Totoleheros/tppa-compliant-motorized-polar-alignment/IMAGES/fysetc_e4_layout.jpg

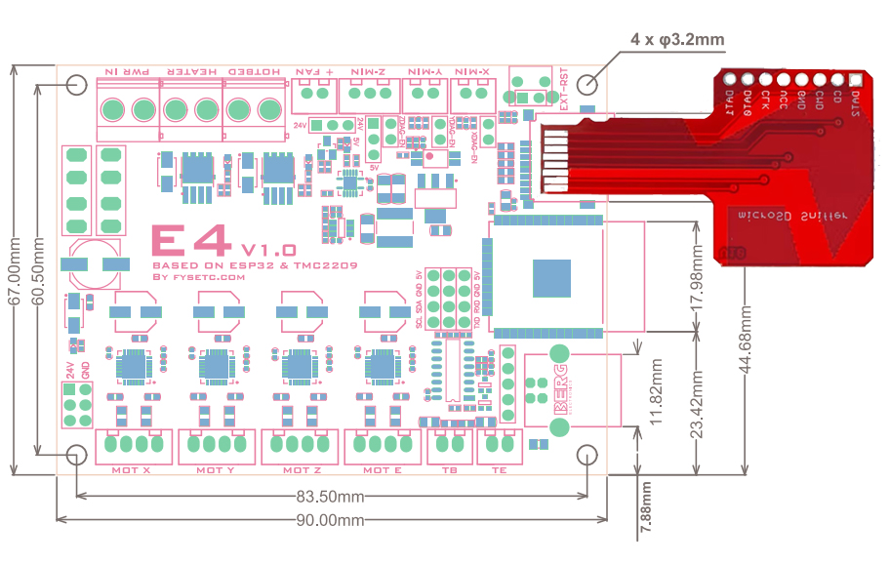
IMAGES/fysetc_e4_layout.jpg
