Totoleheros/tppa-compliant-motorized-polar-alignment/IMAGES/Parts_Proto/load-bearing.jpg

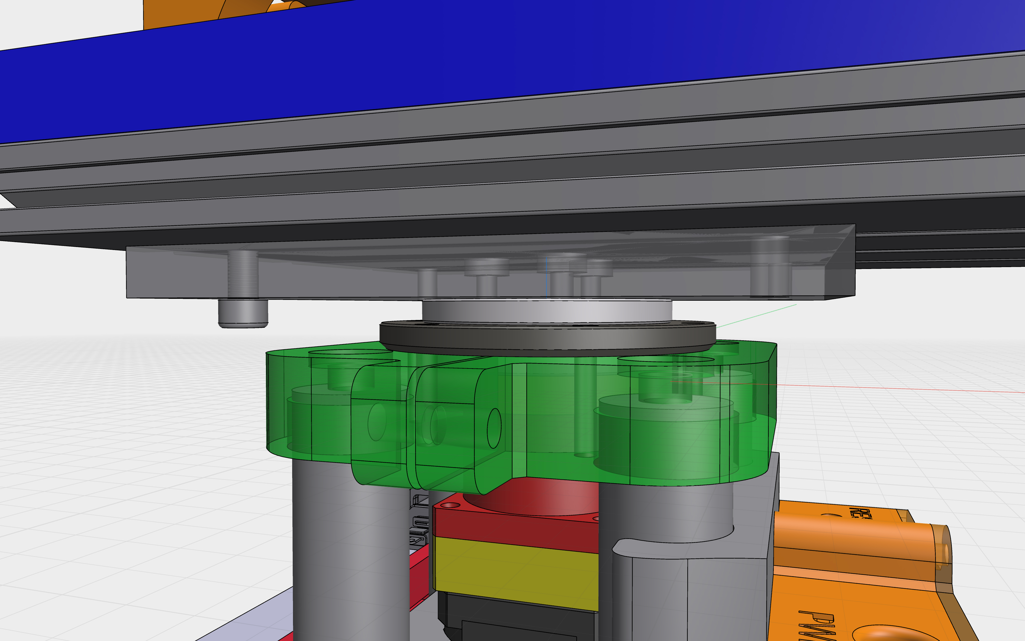
IMAGES/Parts_Proto/load-bearing.jpg
