Totoleheros/tppa-compliant-motorized-polar-alignment/IMAGES/ASSEMBLY_Proto/3D_Model/25.jpg

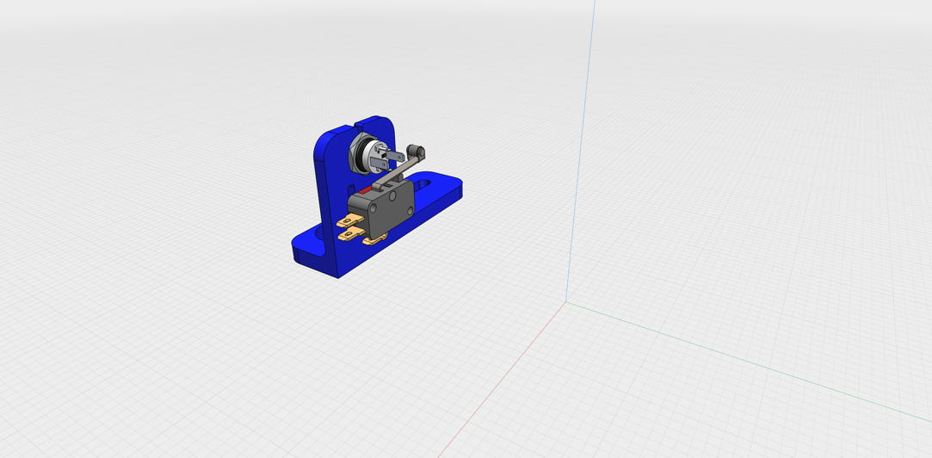
IMAGES/ASSEMBLY_Proto/3D_Model/25.jpg
