Totoleheros/tppa-compliant-motorized-polar-alignment/IMAGES/ASSEMBLY_Proto/3D_Model/31.jpg

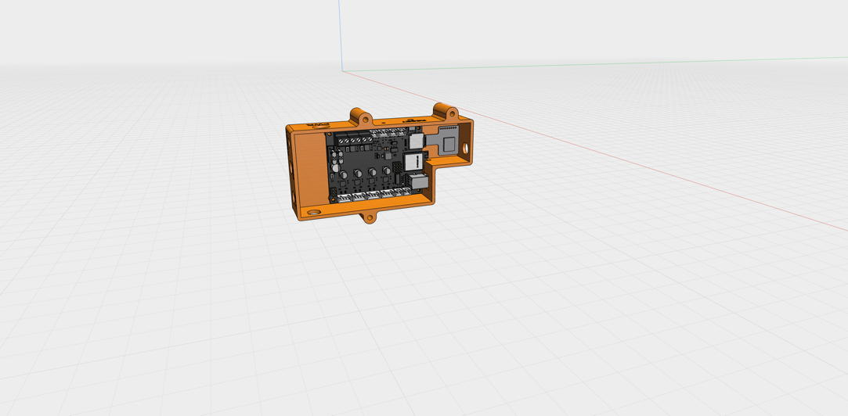
IMAGES/ASSEMBLY_Proto/3D_Model/31.jpg
