Totoleheros/tppa-compliant-motorized-polar-alignment/IMAGES/ASSEMBLY_Proto/Real_World/ALT-AZM junction/IMG_2272.jpg

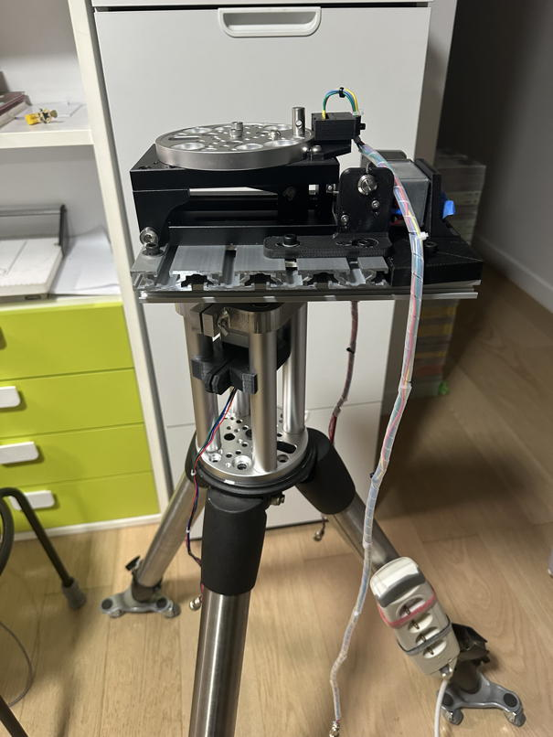
IMAGES/ASSEMBLY_Proto/Real_World/ALT-AZM junction/IMG_2272.jpg
