Totoleheros/tppa-compliant-motorized-polar-alignment/IMAGES/ASSEMBLY_Proto/Real_World/AZM/IMG_2148.jpg

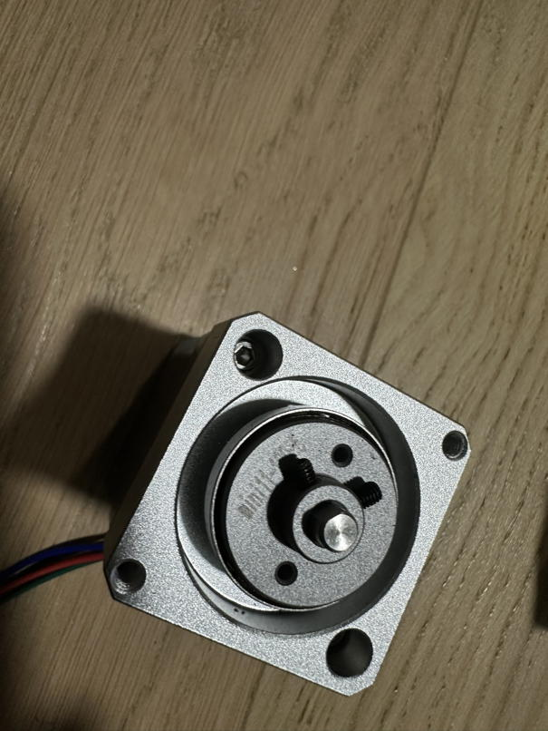
IMAGES/ASSEMBLY_Proto/Real_World/AZM/IMG_2148.jpg
