Totoleheros/tppa-compliant-motorized-polar-alignment/IMAGES/ASSEMBLY_Proto/Real_World/AZM/IMG_2177.jpg

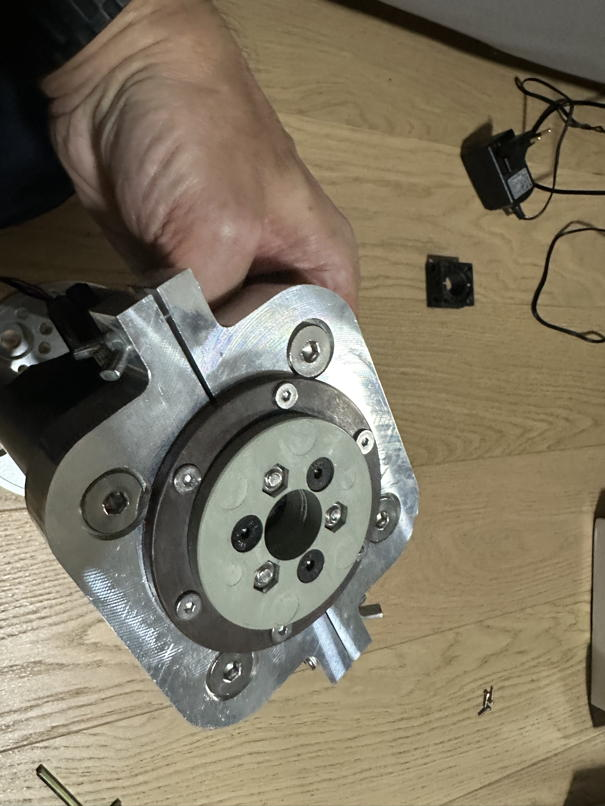
IMAGES/ASSEMBLY_Proto/Real_World/AZM/IMG_2177.jpg
