Totoleheros/tppa-compliant-motorized-polar-alignment/IMAGES/ASSEMBLY_Proto/Real_World/Final Assembly and Scope Loading/IMG_2288.jpg

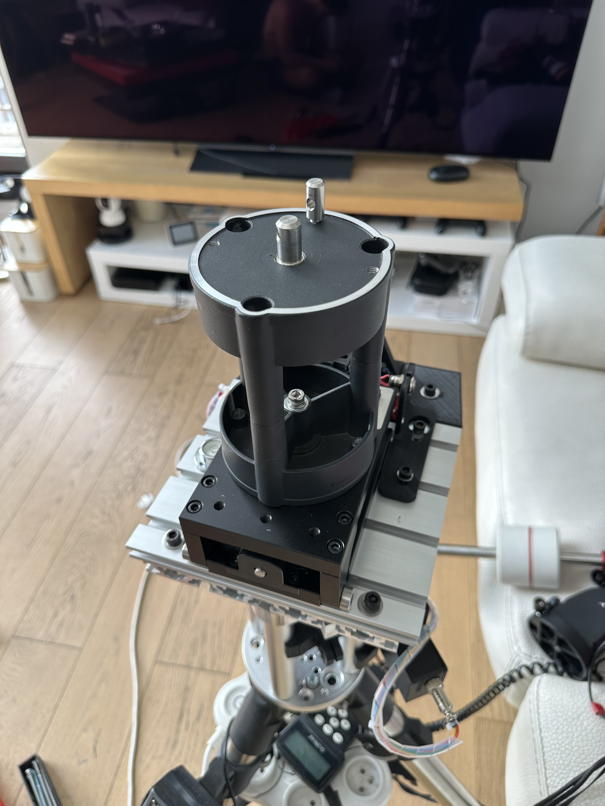
IMAGES/ASSEMBLY_Proto/Real_World/Final Assembly and Scope Loading/IMG_2288.jpg
