Totoleheros/tppa-compliant-motorized-polar-alignment/IMAGES/ASSEMBLY_Proto/Real_World/Fysetc/IMG_2209.jpg

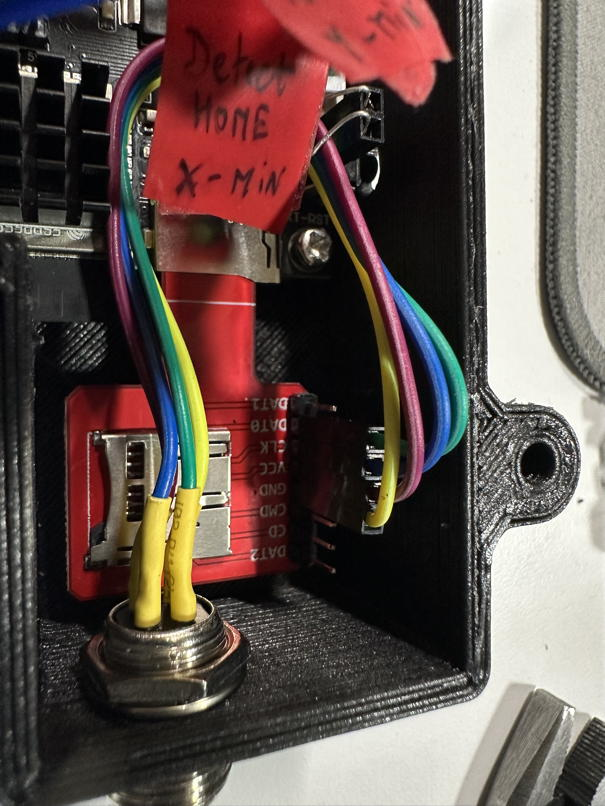
IMAGES/ASSEMBLY_Proto/Real_World/Fysetc/IMG_2209.jpg
