Totoleheros/tppa-compliant-motorized-polar-alignment/IMAGES/ASSEMBLY_Proto/Real_World/Fysetc/IMG_2222.jpg

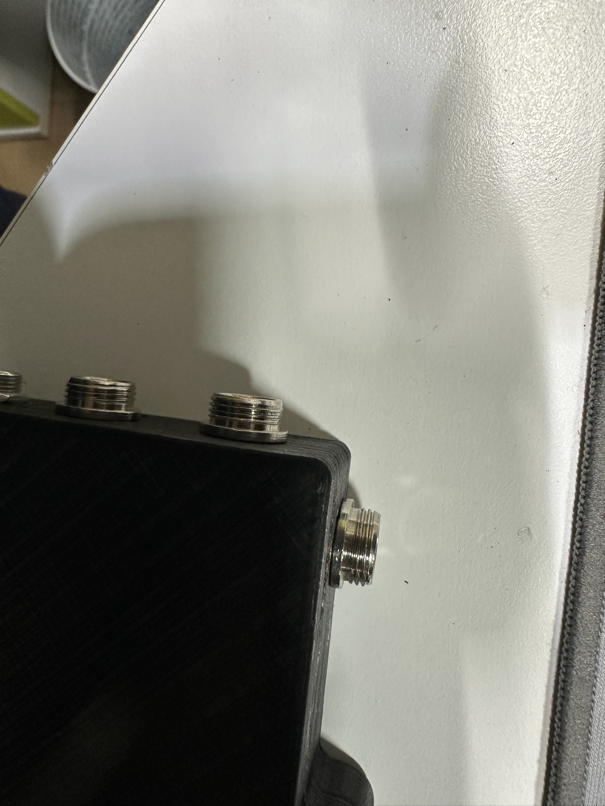
IMAGES/ASSEMBLY_Proto/Real_World/Fysetc/IMG_2222.jpg
