Totoleheros/tppa-compliant-motorized-polar-alignment/IMAGES/ASSEMBLY_Proto/Real_World/Ready to go/IMG_2300.jpg

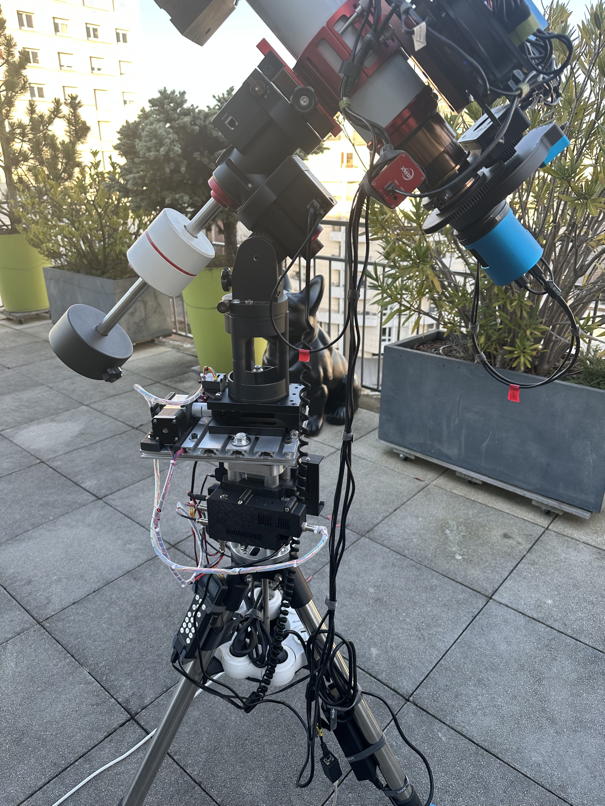
IMAGES/ASSEMBLY_Proto/Real_World/Ready to go/IMG_2300.jpg
