Totoleheros/tppa-compliant-motorized-polar-alignment/IMAGES/ASSEMBLY_V2/3D_Model/23.jpg

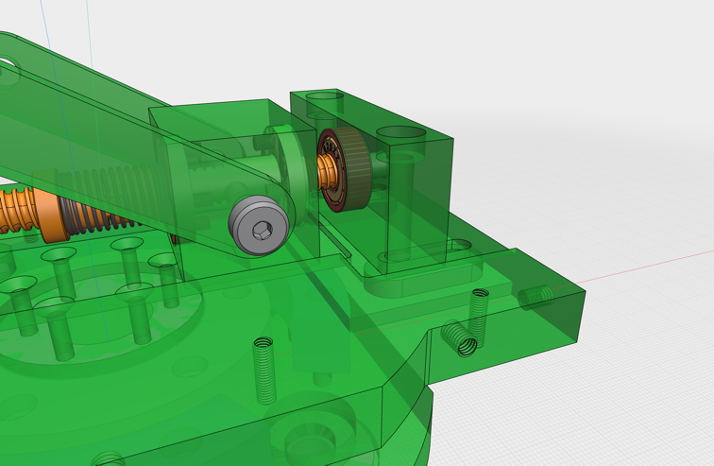
IMAGES/ASSEMBLY_V2/3D_Model/23.jpg
