Totoleheros/tppa-compliant-motorized-polar-alignment/IMAGES/ASSEMBLY_V2/3D_Model/25.jpg

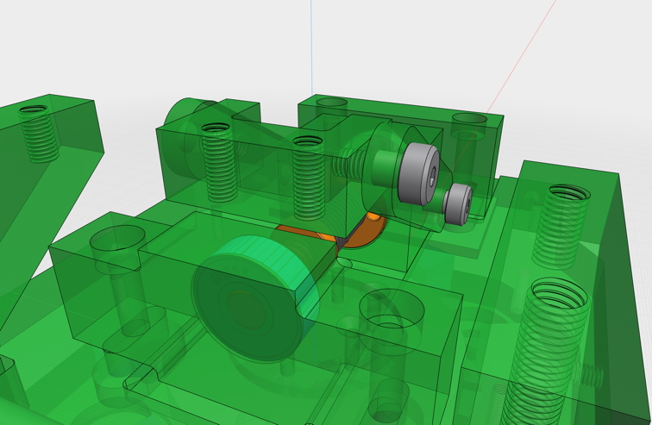
IMAGES/ASSEMBLY_V2/3D_Model/25.jpg
