Totoleheros/tppa-compliant-motorized-polar-alignment/IMAGES/ASSEMBLY_V2/Real_World/IMG_2485.jpg

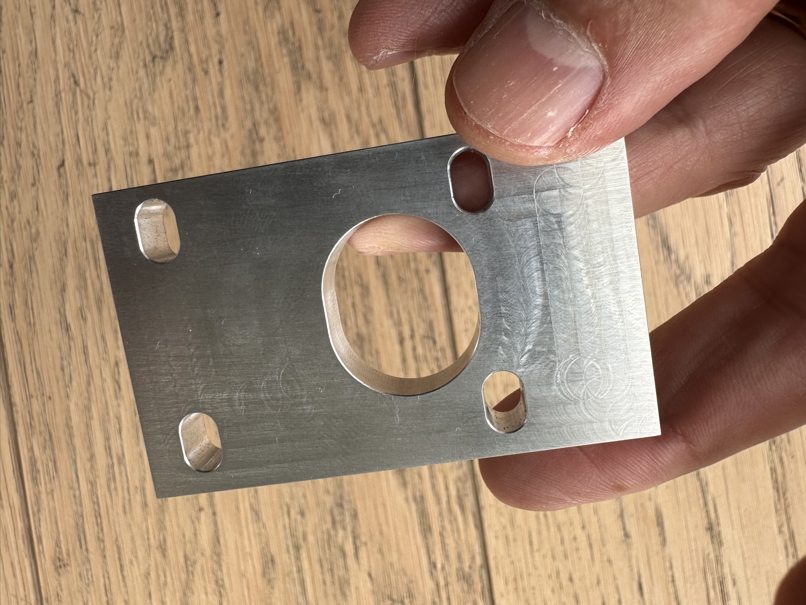
IMAGES/ASSEMBLY_V2/Real_World/IMG_2485.jpg
