Totoleheros/tppa-compliant-motorized-polar-alignment/IMAGES/ASSEMBLY_V2_Reinforced/Real_World/IMG_2876.jpg

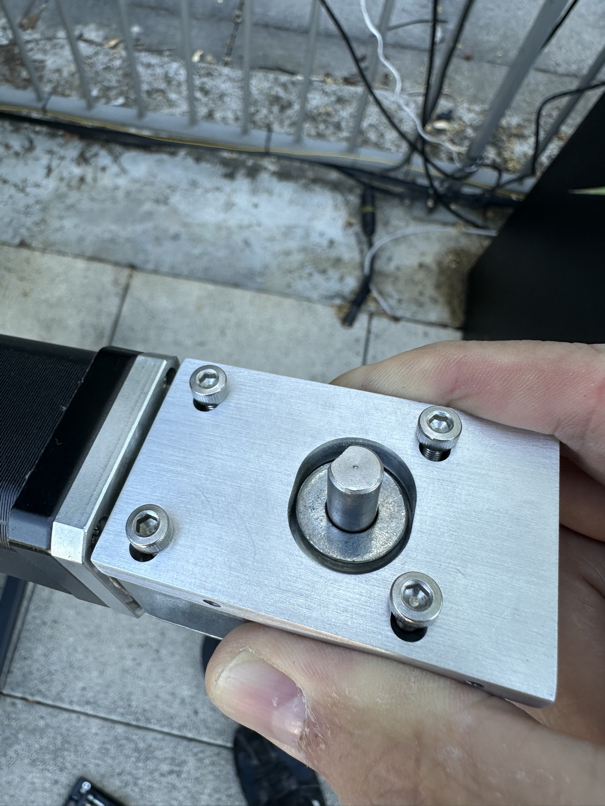
IMAGES/ASSEMBLY_V2_Reinforced/Real_World/IMG_2876.jpg
