Totoleheros/tppa-compliant-motorized-polar-alignment/3D STEP Models/Manufacturing_Drawings_V2_2_reinforced/BASE_ALT.pdf

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

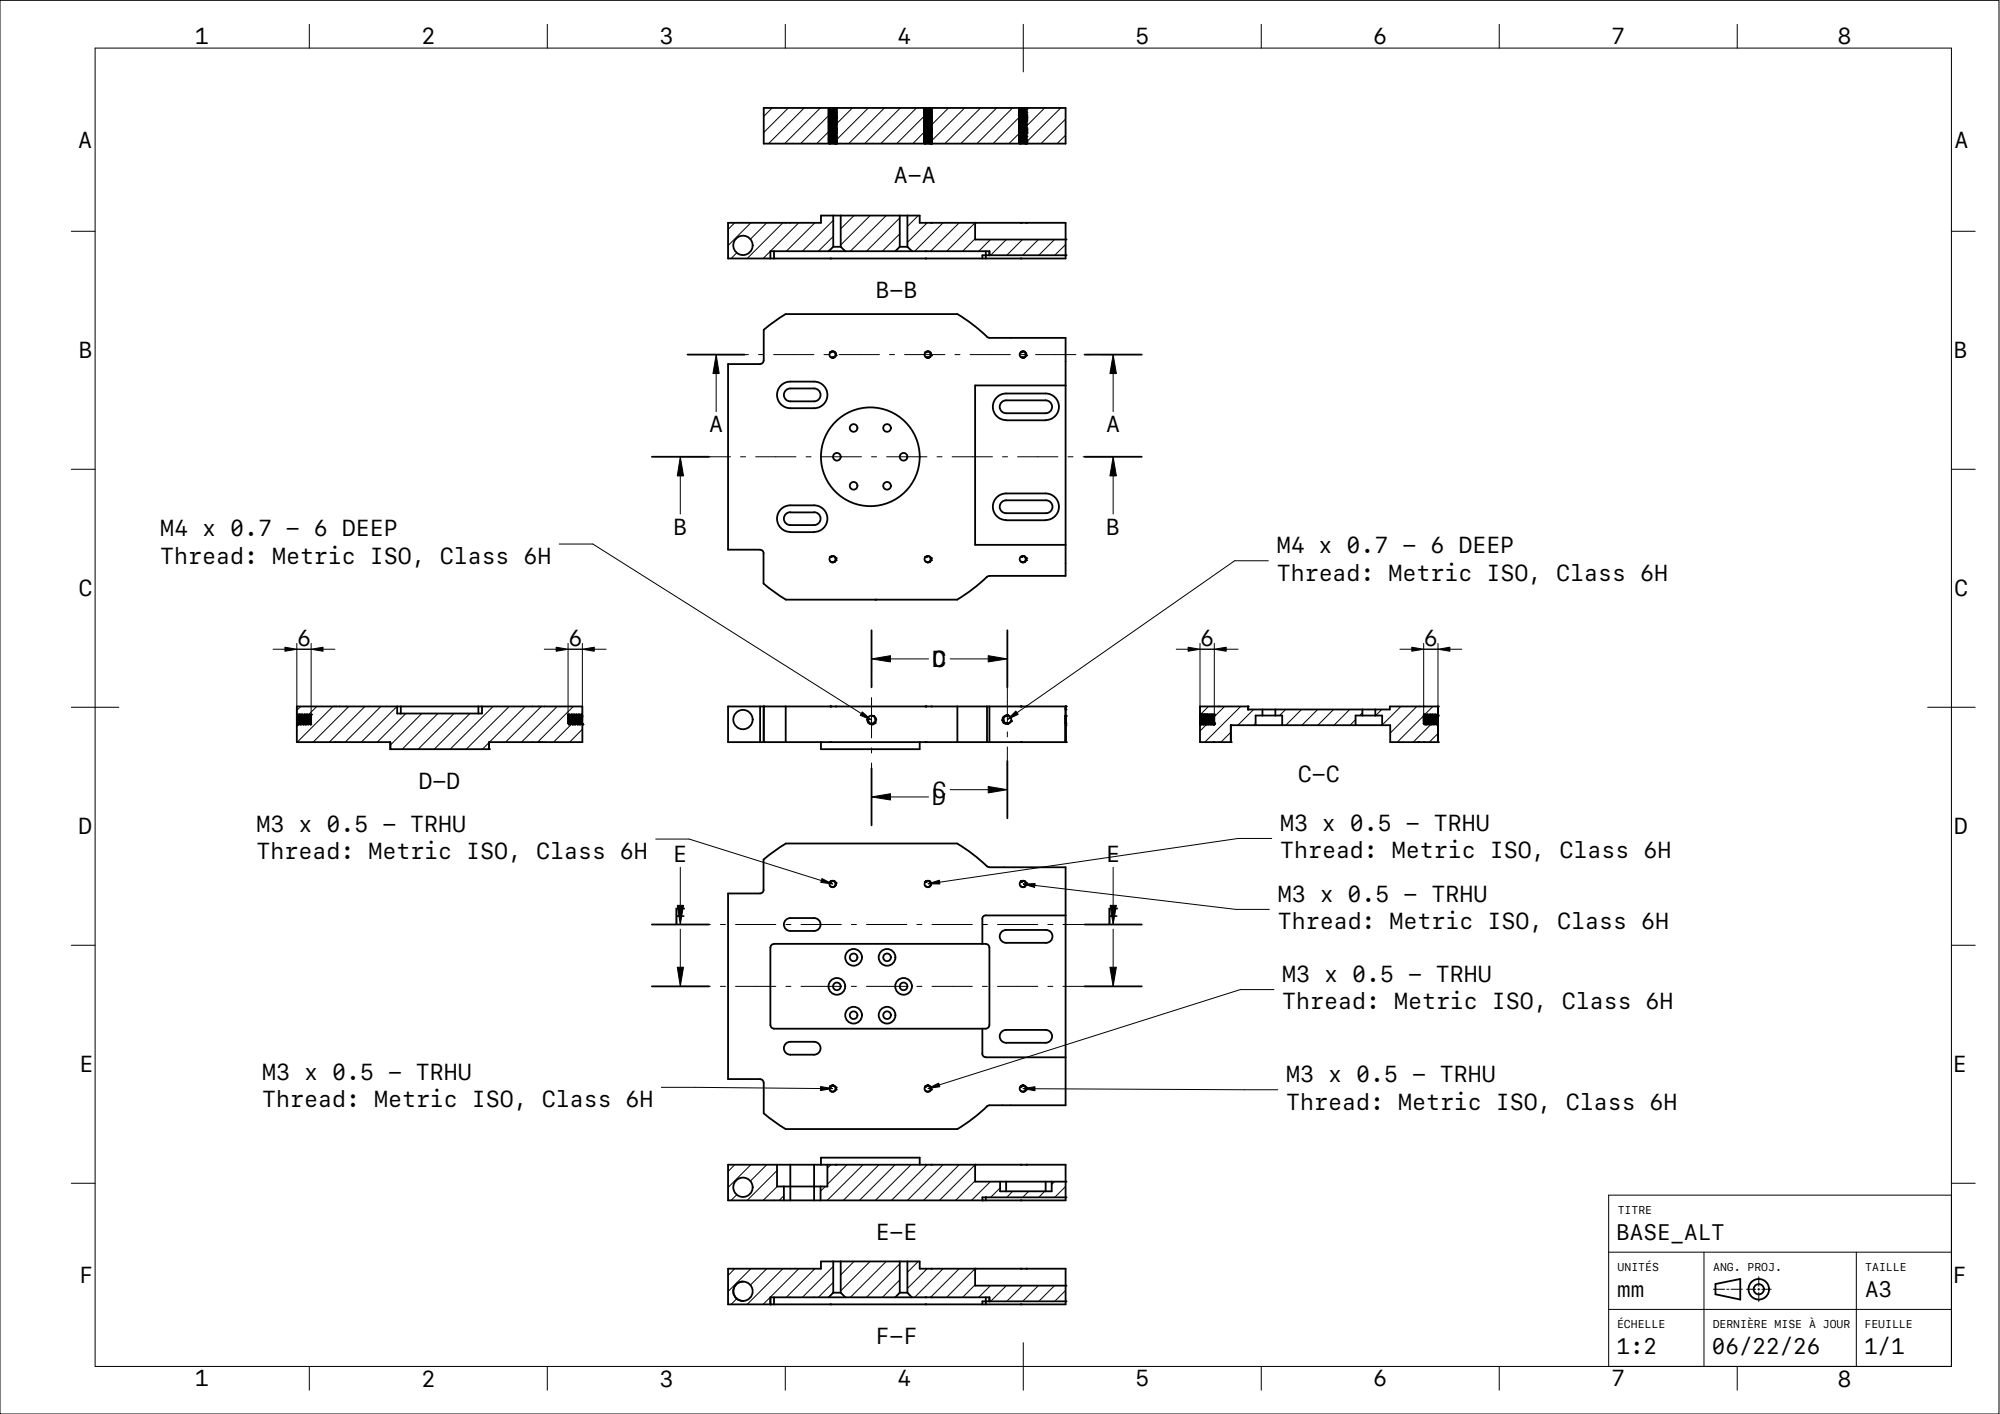
[picture p267: page 1]
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
