Totoleheros/tppa-compliant-motorized-polar-alignment/3D STEP Models/Manufacturing_Drawings_V2/Base_ALT_T.pdf

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

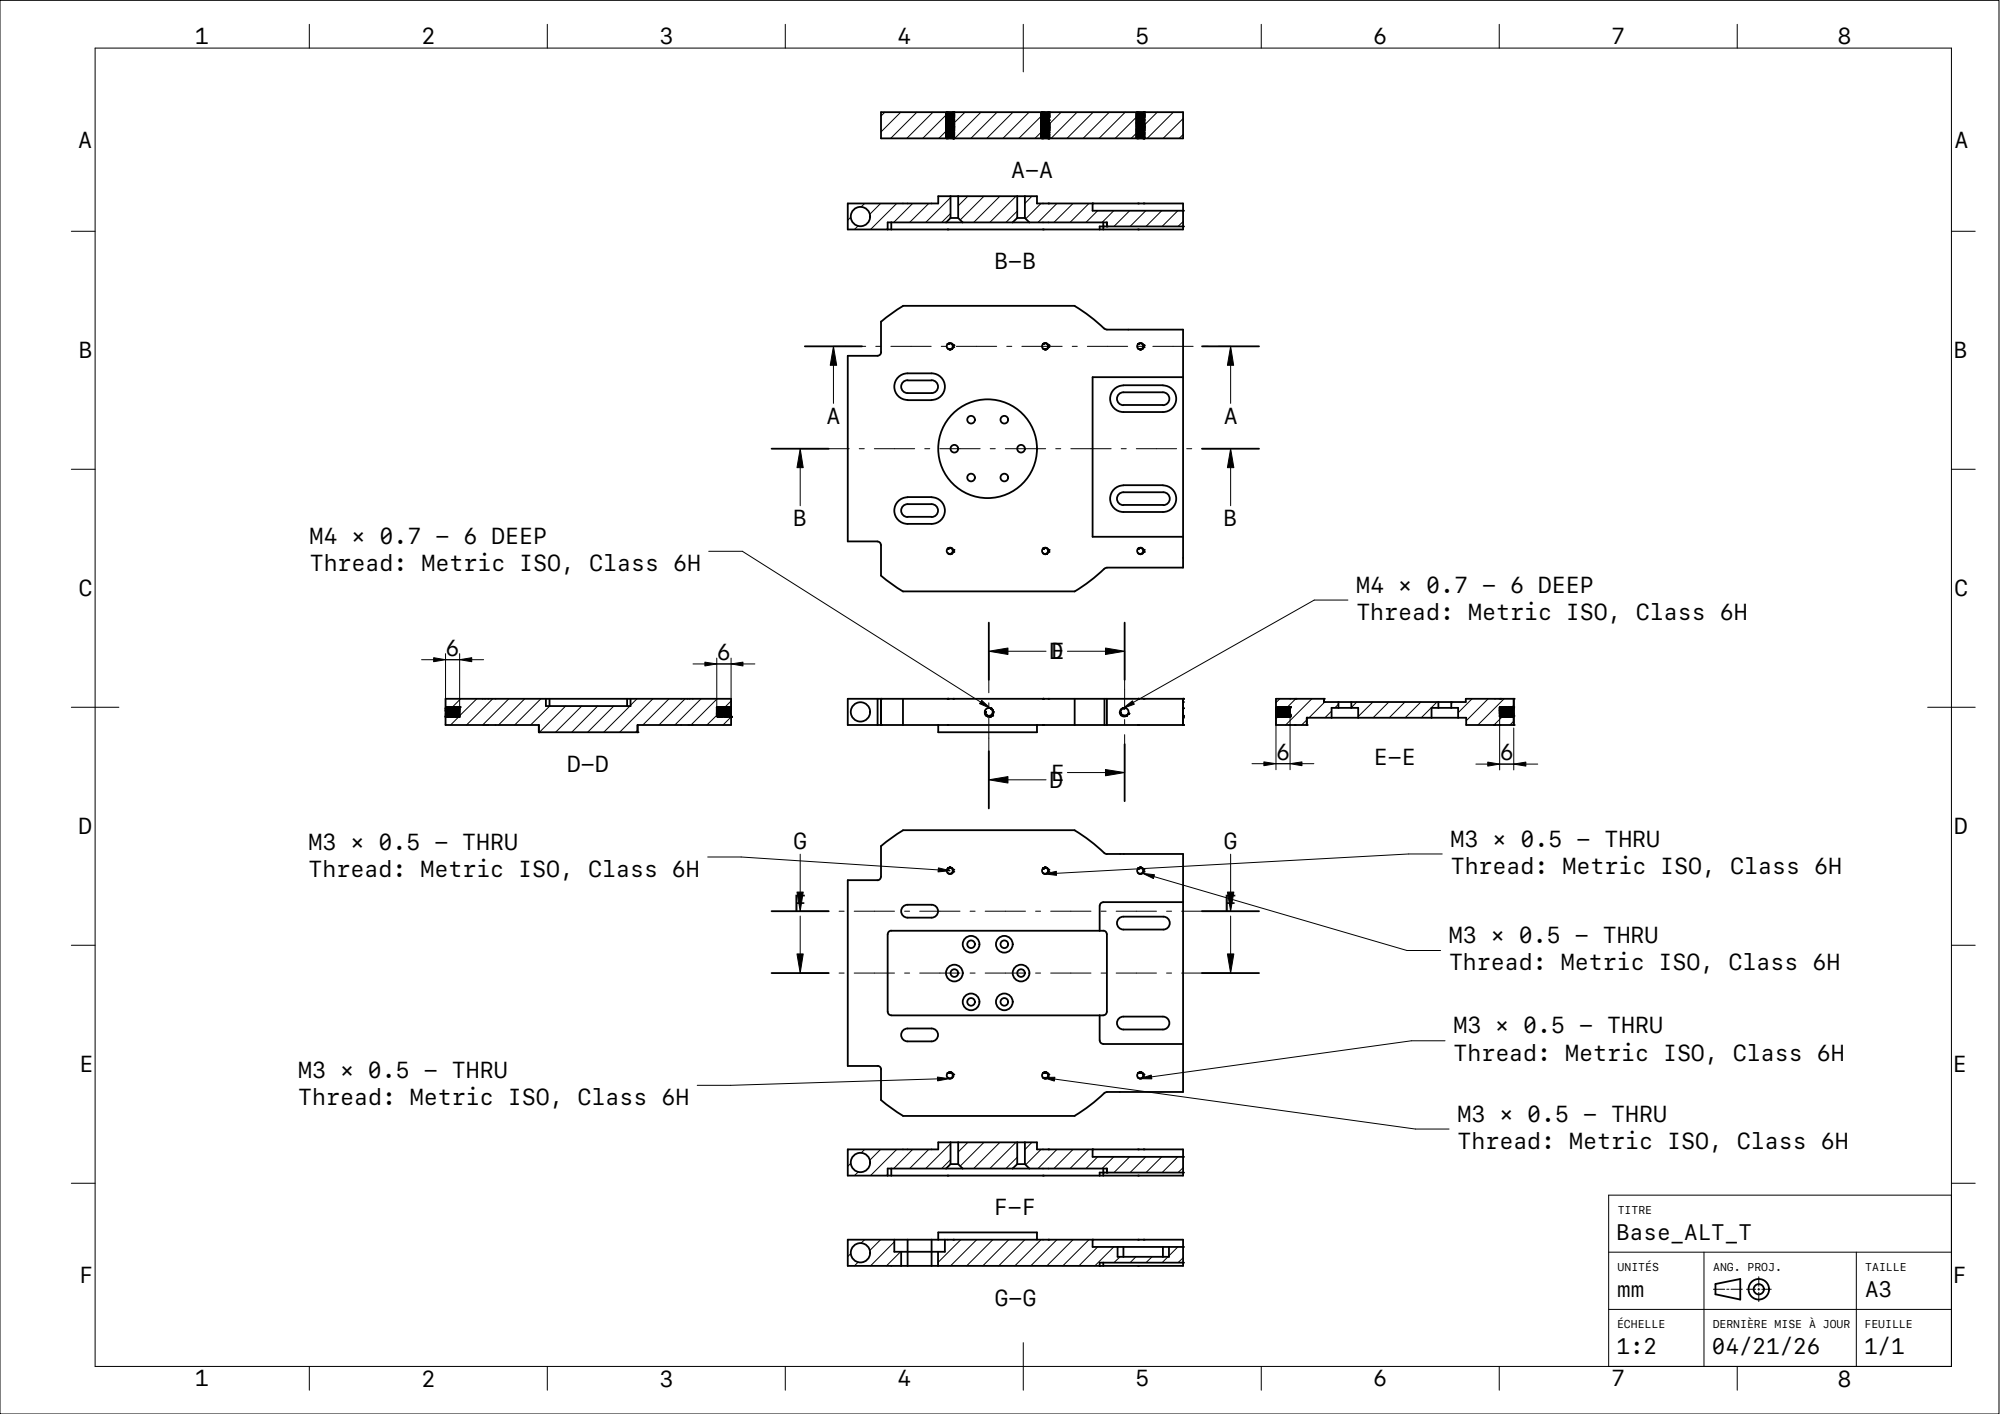
[picture p274: page 1]
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
