Totoleheros/tppa-compliant-motorized-polar-alignment/(commit log)

2026-09-28 Resolve README.md merge conflicts — v16.03 docs
2026-10-11 Add FYSETC E4 V1.0 wiring diagram (HTML + board image)
